masoncj/esp32-lighthouse/board/outputs/esp32-lighthouse-9dof-single-v1-black.png

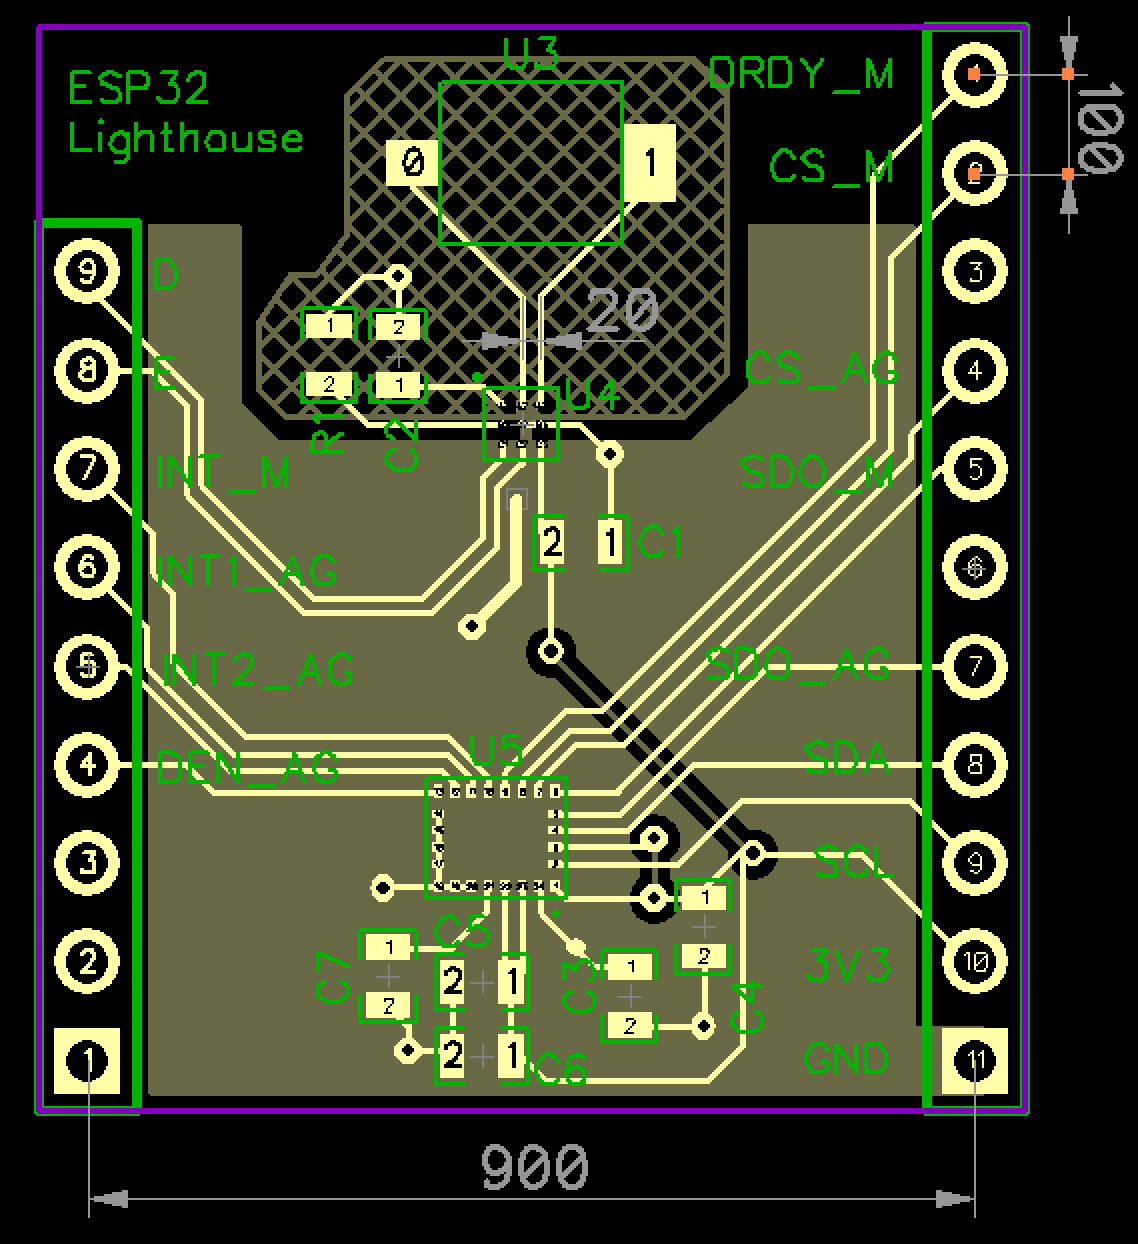
board/outputs/esp32-lighthouse-9dof-single-v1-black.png
