masoncj/esp32-lighthouse/board/outputs/esp32-lighthouse-9dof-single-v1-board.pdf

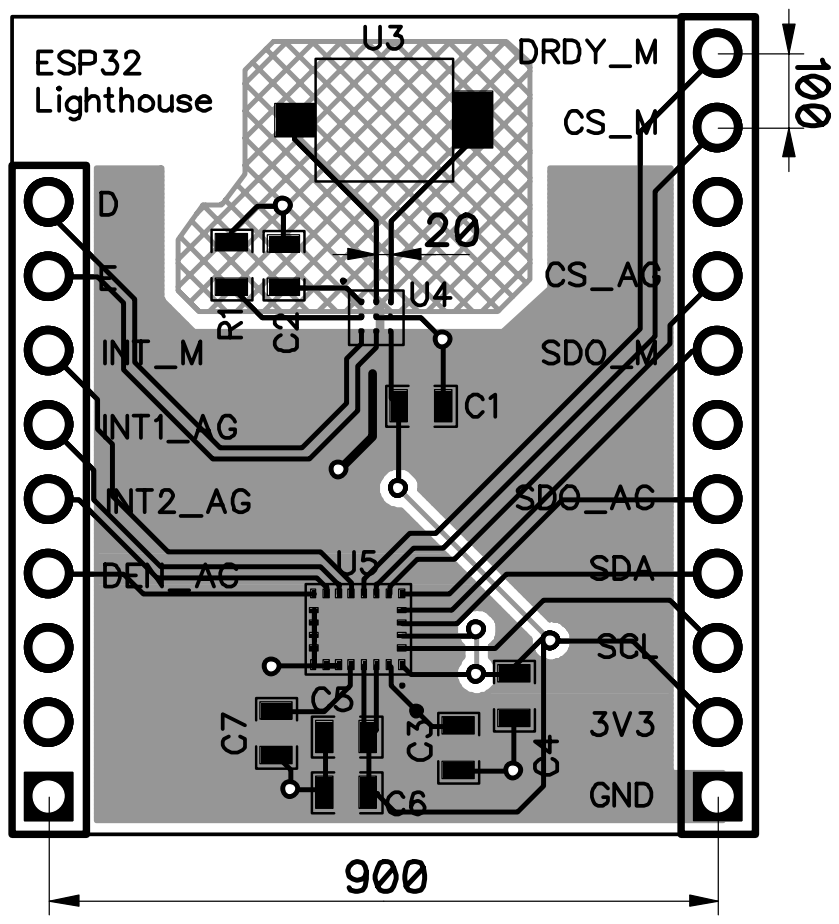
[picture p4: page 1]
