masoncj/esp32-lighthouse/board/outputs/esp32-lighthouse-9dof-single-v1-schem.pdf

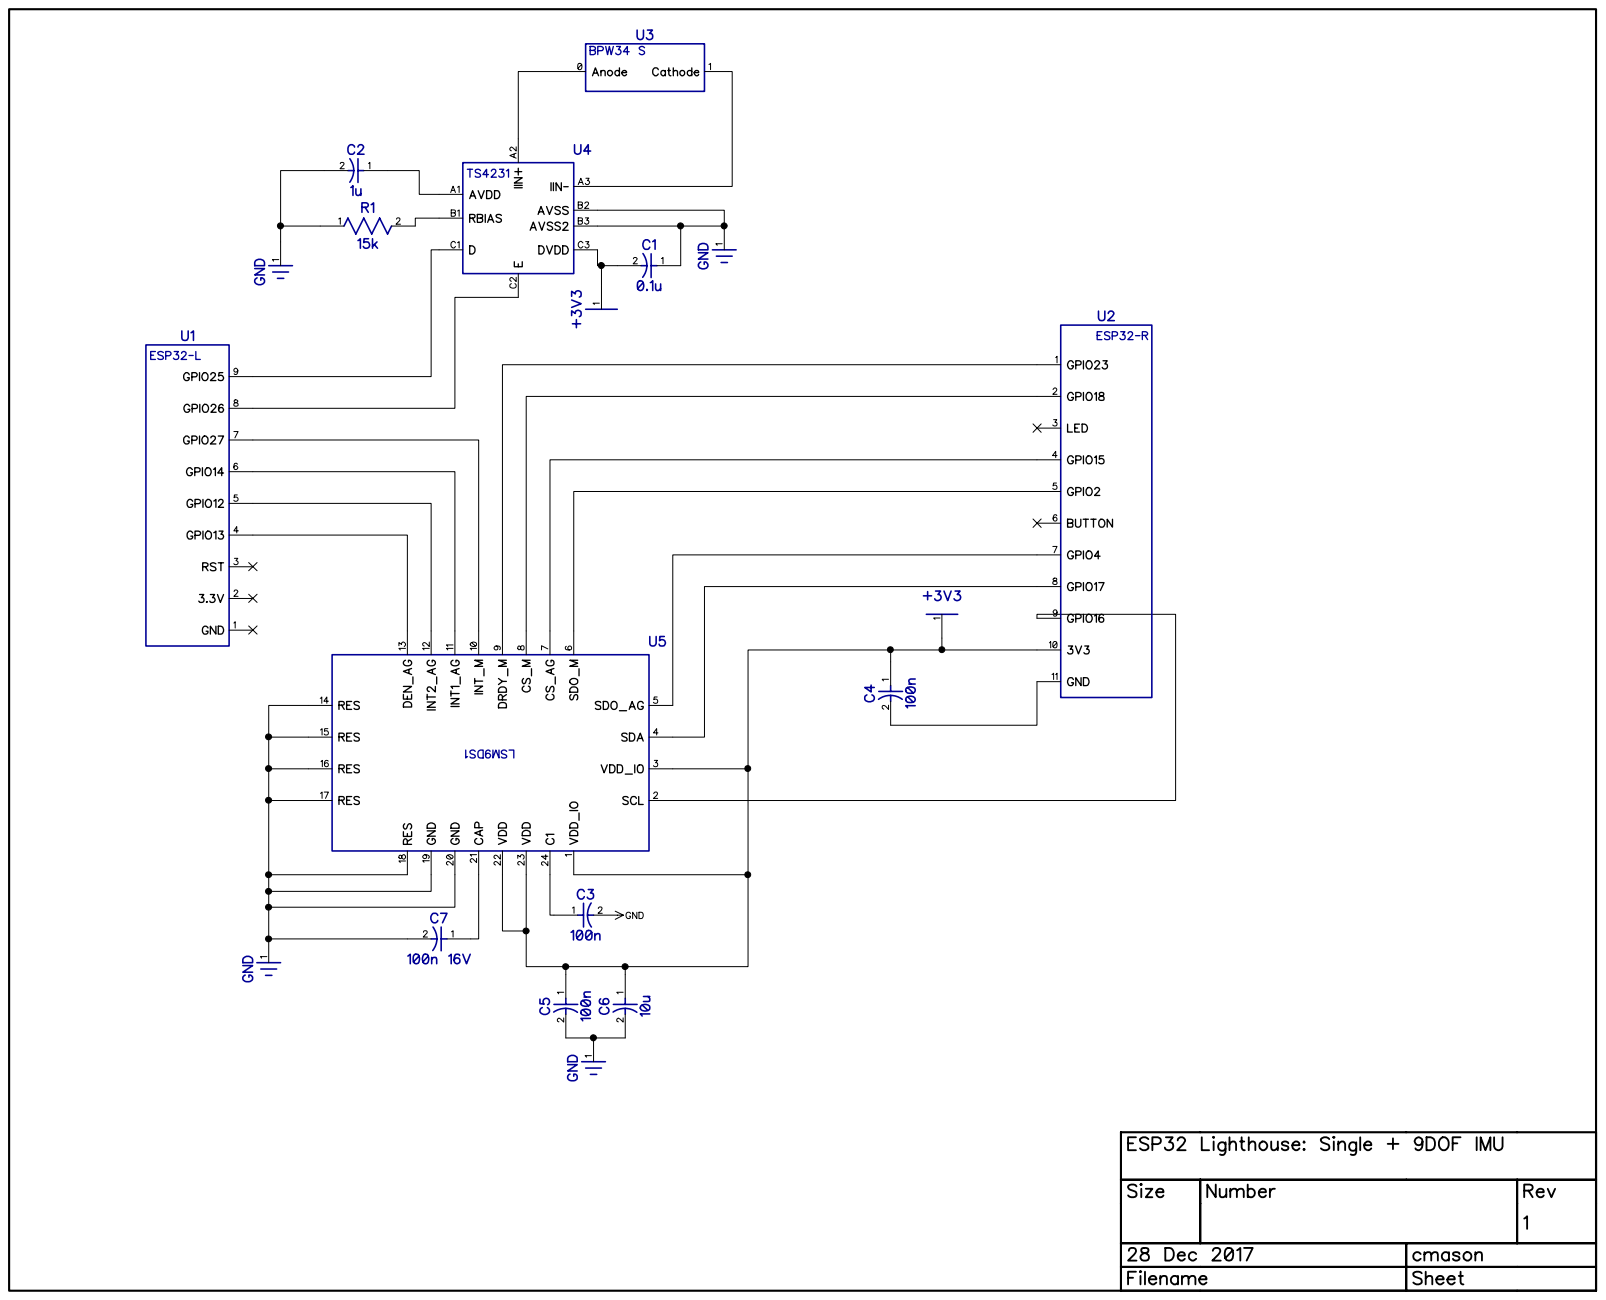
[picture p5: page 1]
