masoncj/esp32-lighthouse/(list of files, drawings)

Other design files:
board/esp32-lighthouse-9dof-single.dch
board/esp32-lighthouse-9dof-single.dip
