masoncj/esp32-lighthouse/board/kicad_attempt/esp32-lighthouse-9dof-single.kicad_pcb

## KiCad design board/kicad_attempt/esp32-lighthouse-9dof-single.kicad_pcb (2017-12-29)

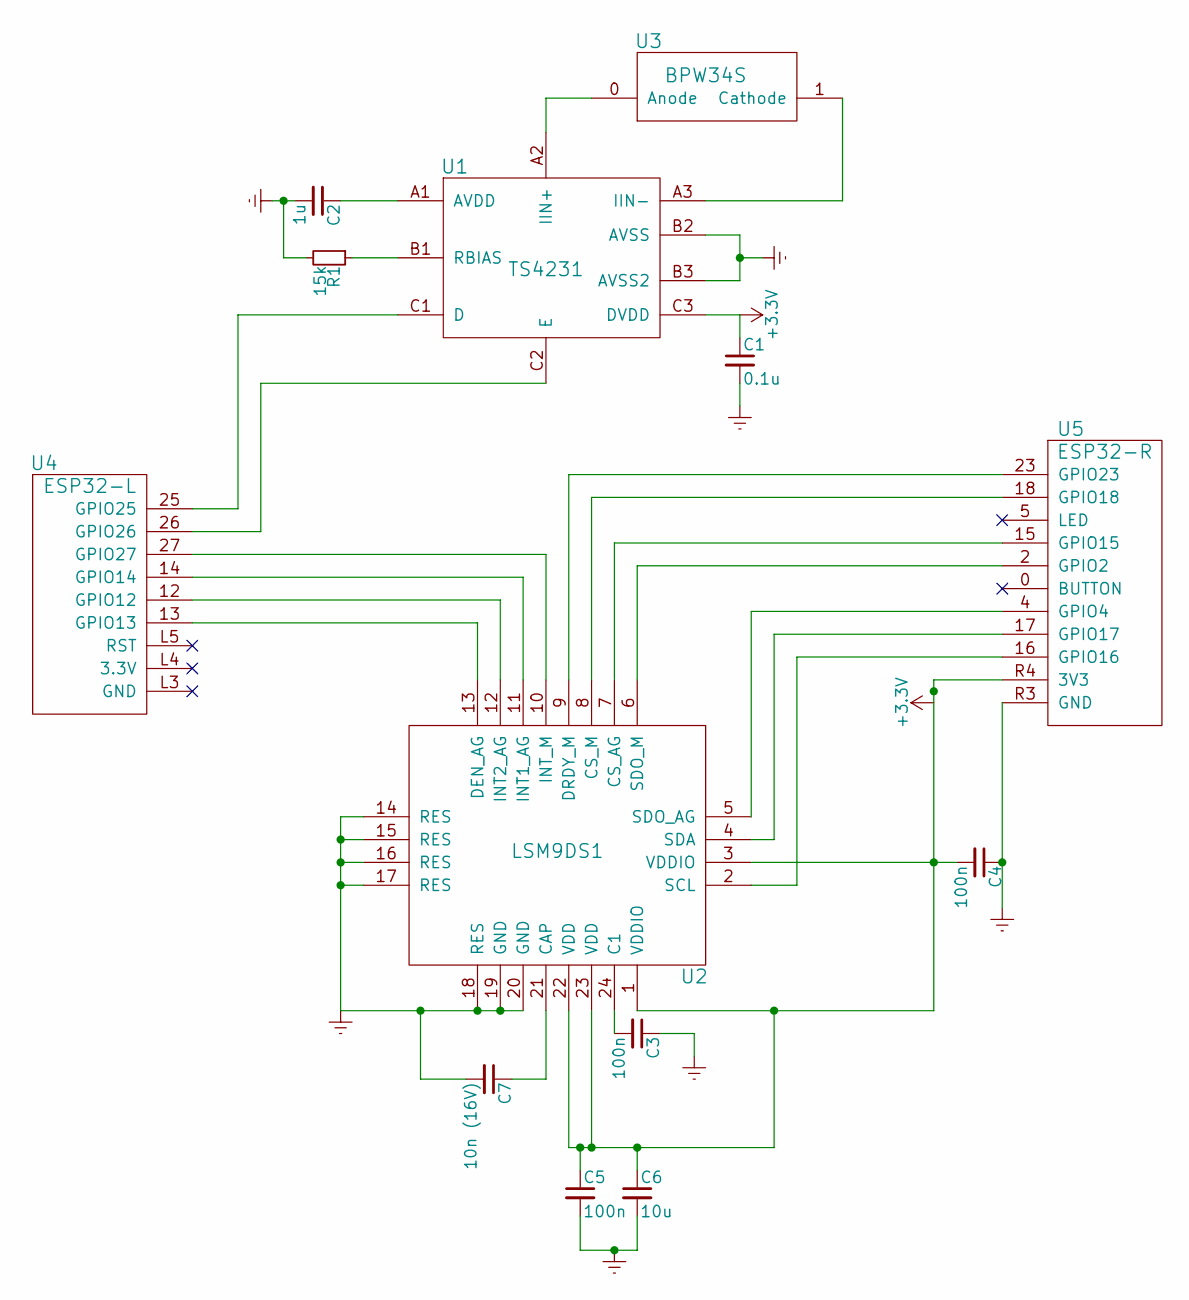
[picture p6: schematic esp32-lighthouse-9dof-single.sch]

Parts:
C1: 0.1u; C_0603
C2: 1u; C_0603
C3, C4, C5: 100n; C_0603
C6: 10u; C_0603
C7: 10n (16V); C_0603
R1: 15k; R_0603
U1: TS4231
U2: LSM9DS1
U3: BPW34S
U4: ESP32-L
U5: ESP32-R

Connections:
Earth: C1.2, C2.2, C3.1, C4.1, C5.2, C6.2, C7.2, R1.2, U1.B2 (AVSS), U1.B3 (AVSS2), U2.14 (RES), U2.15 (RES), U2.16 (RES), U2.17 (RES), U2.18 (RES), U2.19 (GND), U2.20 (GND), U5.R3 (GND)
unnamed: C2.1, U1.A1 (AVDD)
unnamed: C3.2, U2.24 (C1)
unnamed: C7.1, U2.21 (CAP)
unnamed: R1.1, U1.B1 (RBIAS)
unnamed: U1.A2 (IIN+), U3.0 (Anode)
unnamed: U1.A3 (IIN-), U3.1 (Cathode)
unnamed: U1.C1 (D), U4.25 (GPIO25)
unnamed: U1.C2 (E), U4.26 (GPIO26)
unnamed: U2.2 (SCL), U5.16 (GPIO16)
unnamed: U2.4 (SDA), U5.17 (GPIO17)
unnamed: U2.5 (SDO_AG), U5.4 (GPIO4)
unnamed: U2.6 (SDO_M), U5.2 (GPIO2)
unnamed: U2.7 (CS_AG), U5.15 (GPIO15)
unnamed: U2.8 (CS_M), U5.18 (GPIO18)
unnamed: U2.9 (DRDY_M), U5.23 (GPIO23)
unnamed: U2.10 (INT_M), U4.27 (GPIO27)
unnamed: U2.11 (INT1_AG), U4.14 (GPIO14)
unnamed: U2.12 (INT2_AG), U4.12 (GPIO12)
unnamed: U2.13 (DEN_AG), U4.13 (GPIO13)

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
Board: 2 copper layers, 13 parts (0 on the bottom side), 22 nets, no tracks yet.
